cody-barker/ESP32-LED-Rock-Wall-Template/assets/led-rock-wall-webapp.png

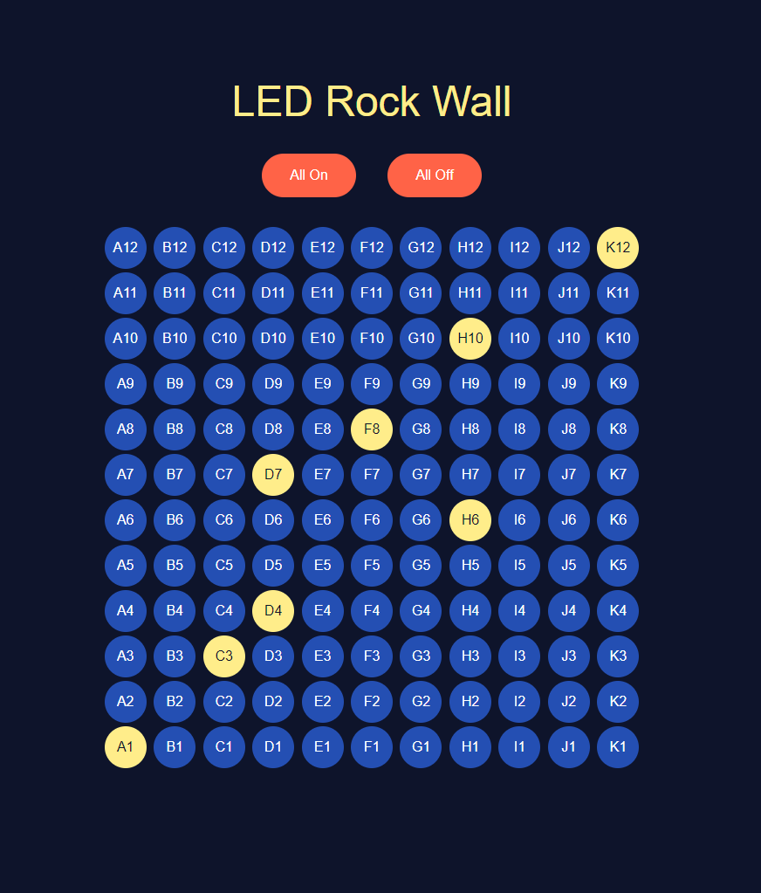
assets/led-rock-wall-webapp.png
