cody-barker/ESP32-LED-Rock-Wall-Template/(commit log)

2024-03-08 add directions for the resistor
2024-03-08 add a couple photos to the bottom of the readme
2024-03-08 add mounted project box photo
2024-03-08 fix typos and add specificity to box of connectors
2024-03-08 adjust text for spi pin message
2024-03-08 remove wire colors
2024-03-08 update connecting power instructions
2024-03-14 add usb to uart driver installation instructions and change esp32 by espressif from library to board manager
